Picatout/ps2_rs232/ps2_rs232_schematic.pdf

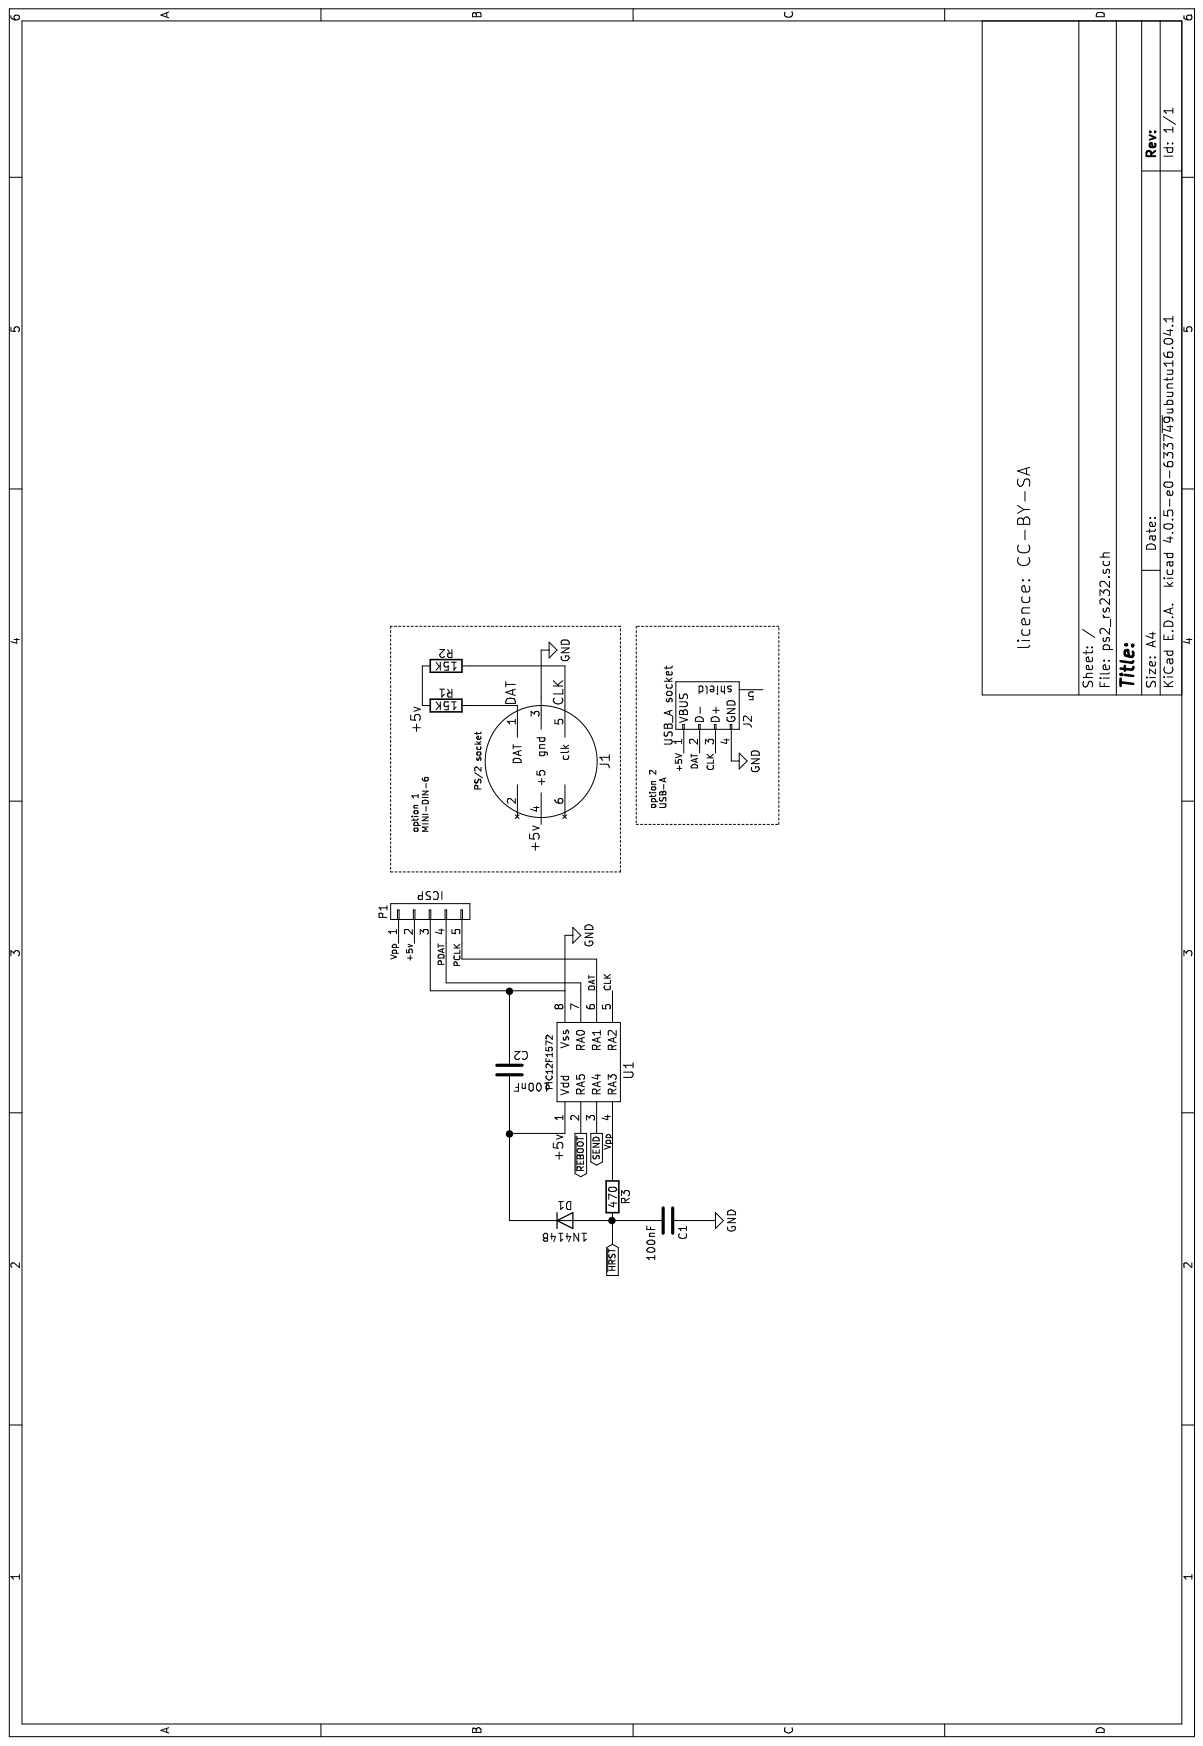
[picture p2: page 1]
