Picatout/ps2_rs232/(commit log)

2016-12-27 ajout des fichiers du projets
    mise à jour readme.md
    [ps2_rs232.kicad_pcb, ps2_rs232.sch]
2017-01-16 ajout diode circuit reset
2017-01-26 ajout option SOFT_REBOOT
    permet de choisir entre un signal reboot en software (code 255) ou un signal reboot hardware sur RA5
    [ps2_rs232.asm]
2017-04-06 modification acceptation touches CTRL_x où x est une lettre renvoie l'ordre l'alphabétique de la lettre
2017-04-06 correction bogue dans rojutine _control
    [ps2_rs232.asm]
2017-04-13 correction bogue, touche DELETE n'était pas transmise.
    [ps2_rs232.asm]
2018-01-19 ajouter code pour réinitialiser le mcu lors d'une erreur de réception du clavier
2018-01-23 odification au projet ps2_rs232 pour ajouter touches virtuelles <CTRL>-<DEL> et changer la valeur de <CTRL>-<BACKSPACE>
